cmeldas/ElZa/README.md

# ElZa
Elektronické zapalování

Pokus o elektronické zapalování.
