cmeldas/ElZa/zapojení_minus.png

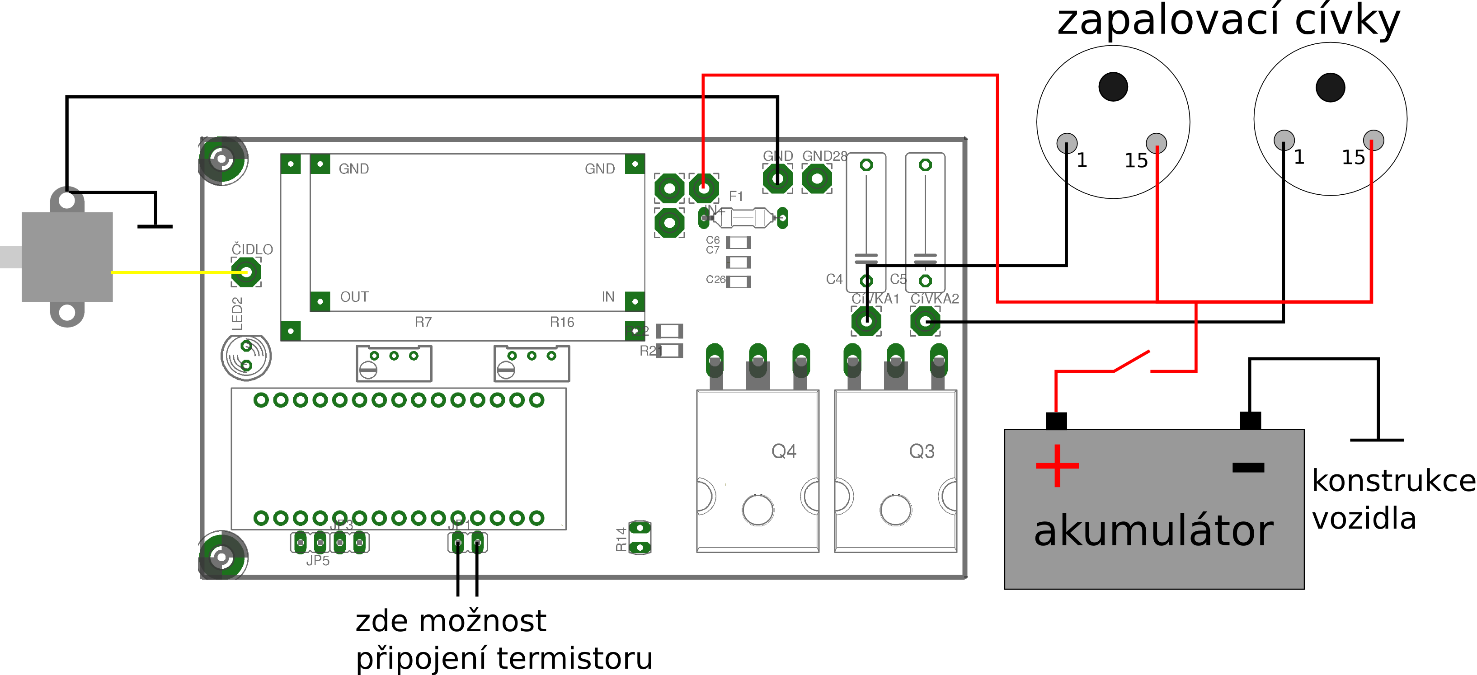
zapojení_minus.png
