cmeldas/ElZa/zapojení_plus.png

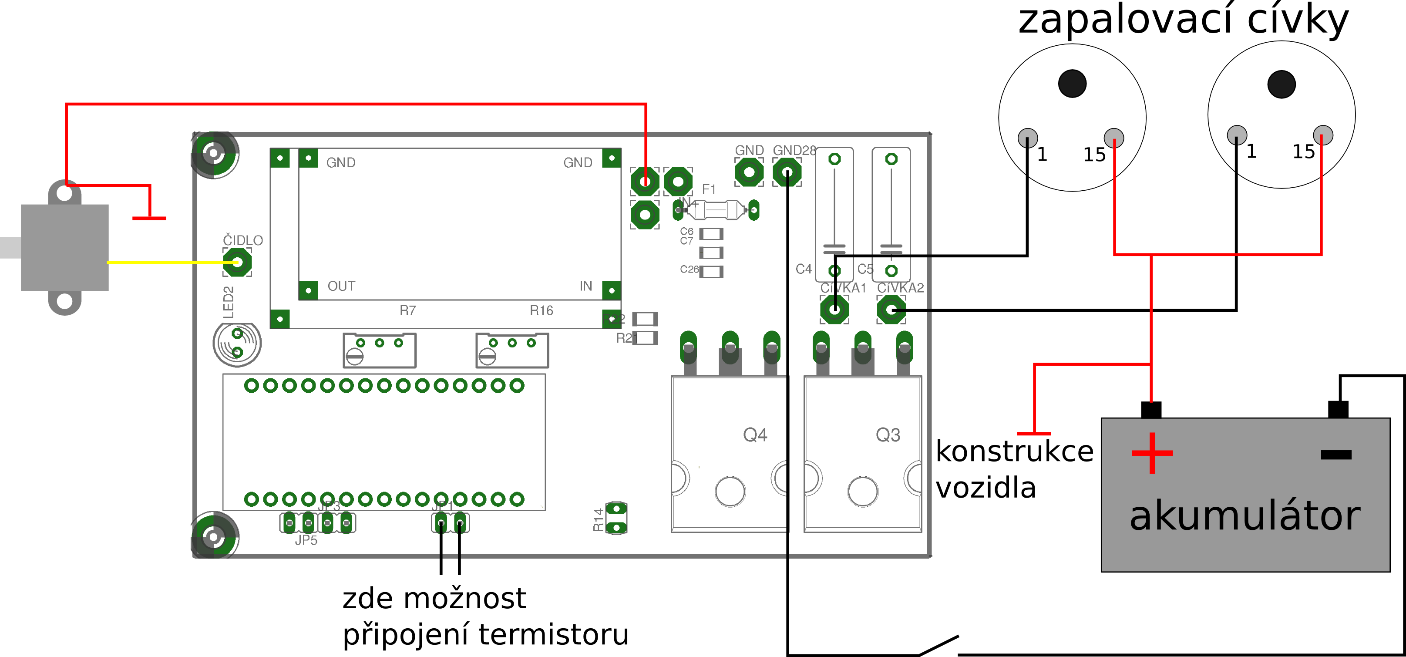
zapojení_plus.png
