cmeldas/ElZa/Eagle/Zapalování_ARDUINO.brd

## EAGLE design Eagle/Zapalování_ARDUINO.brd (2016-06-01)

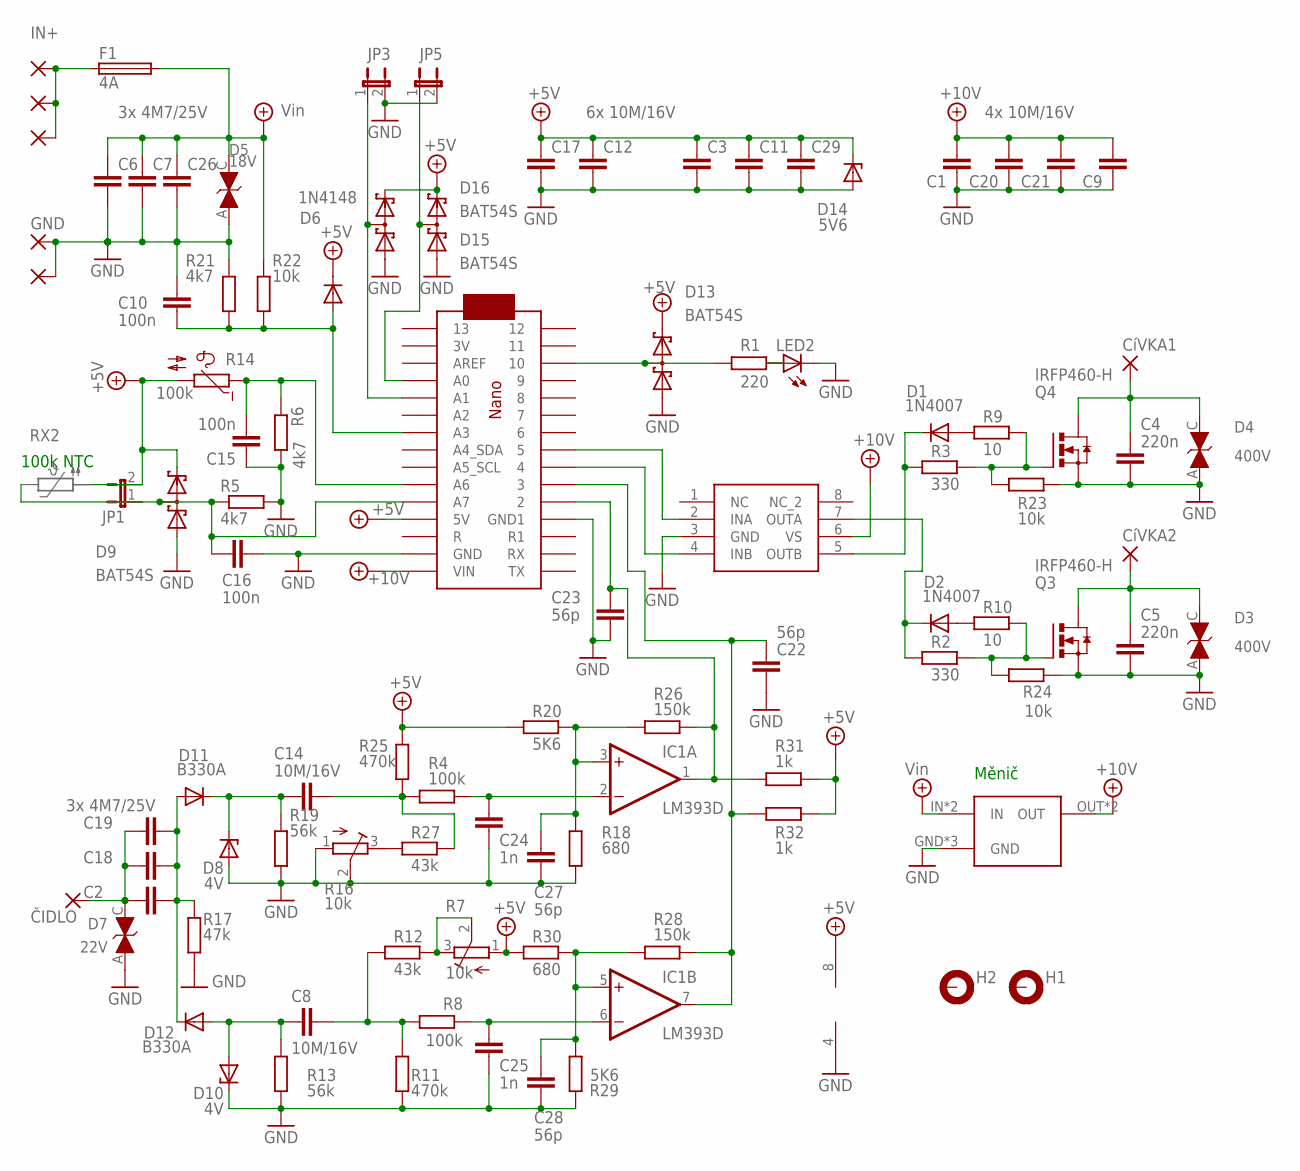
[picture p3: schematic Zapalování_ARDUINO.sch]

Parts:
C1, C8, C9, C11, C12, C14, C17, C20, C29: 10M/16V; C1206K
C2, C26: 3x 4M7/25V; C1206K
C3: 6x 10M/16V; C1206K
C4, C5: 220n; C150-054X183
C6, C7, C18, C19: 4M7/25V; C1206K
C10, C15, C16: 100n; C1206K
C21: 4x 10M/16V; C1206K
C22, C23, C27, C28: 56p; C1206K
C24, C25: 1n; C1206K
CIVKA+: 3,81/1,4
CíVKA1, CíVKA2: 3,81/1,4
CíVKA+: 3,81/1,4
D1, D2: 1N4007; SMA-DO214AC
D3, D4: 400V; SMC
D5: 18V; SMC
D6: 1N4148; SOD80C
D7: 22V; SMC
D8, D10: 4V; SOD80C
D9, D13, D15, D16: BAT54S; SOT23
D11, D12: B330A; DO214BA
D14: 5V6; SOD80C
F1: 4A; PICOFUSE
GND, GND28: 3,81/1,4
H1, H2: MOUNT-PAD-ROUND3.0; 3,0-PAD
IC1: LM393D; SO08
IN+: 3,81/1,4
JP1, JP3, JP5: JP1E; JP1
LED2: LED5MM
Q3, Q4: IRFP460-H; TO247BH
R1: 220; M1206
R2, R3: 330; M1206
R4, R8: 100k; M1206
R5, R6, R21: 4k7; M1206
R7, R16: 10k; RTRIM64W
R9, R10: 10; M1206
R11, R25: 470k; M1206
R12, R27: 43k; M1206
R13, R19: 56k; M1206
R14: 100k; N640
R17: 47k; M1206
R18, R30: 680; M1206
R20, R29: 5K6; M1206
R22, R23, R24: 10k; M1206
R26, R28: 150k; M1206
R31, R32: 1k; M1206
U$1: ARDUINO_NANO
U$2: IR25600/TC4427; SO08
U$3: STEP:DOWN; STEP-BOARD
ČIDLO: 3,81/1,4

Connections:
+5V: C3.1, C11.1, C12.1, C17.1, C29.1, D6.C, D9.2 (C2), D13.2 (C2), D14.C, D15.2 (C2), D16.2 (C2), IC1.8 (V+), JP1.2, R7.1 (A), R14.2, R20.2, R25.2, R30.2, R31.1, R32.1, U$1.P$23 (5V)
+14V: C6.1, C7.1, C26.1, D5.C, F1.2, R22.2, U$3.IN, U$3.P$1 (IN)
+15V: C1.2, C9.1, C20.2, C21.2, U$1.P$20 (VIN), U$2.6 (VS), U$3.OUT, U$3.P$2 (OUT)
CIVKA1: U$1.P$8 (5), U$2.2 (INA)
CIVKA2: U$1.P$9 (4), U$2.4 (INB)
GND: C1.1, C3.2, C4.2, C5.2, C6.2, C7.2, C9.2, C10.1, C11.2, C12.2, C15.1, C16.1, C17.2, C20.1, C21.1, C22.2, C23.2, C24.2, C25.2, C26.2, C27.2, C28.2, C29.2, D3.A, D4.A, D5.A, D7.A, D8.A, D9.1 (A1), D10.C, D13.1 (A1), D14.A, D15.1 (A1), D16.1 (A1), GND.1, GND28.1, IC1.4 (V-), JP3.2, JP5.2, LED2.K (C), Q3.S, Q4.S, R5.2, R6.2, R11.1, R13.1, R16.1 (A), R16.2 (S), R17.1, R18.1, R19.1, R21.2, R23.1, R24.1, R29.2, U$1.P$12 (GND), U$1.P$21 (GND1), U$2.3 (GND), U$3.GND, U$3.GND2 (GND), U$3.P$3 (GND)
INT1: C23.1, IC1.1 (OUT), R26.1, R31.2, U$1.P$11 (2)
INT2: C22.1, IC1.7 (OUT), R28.1, R32.2, U$1.P$10 (3)
unnamed: Q4.G, R3.2, R9.2, R23.2
unnamed: D1.K (C), R3.1, U$2.5 (OUTB)
unnamed: C4.1, CíVKA1.1, D4.C, Q4.D
unnamed: Q3.G, R2.2, R10.2, R24.2
unnamed: D2.K (C), R2.1, U$2.7 (OUTA)
unnamed: D15.3 (C1A2), JP3.1, U$1.P$30 (A1)
unnamed: D16.3 (C1A2), JP5.1, U$1.P$31 (A0)
unnamed: D13.3 (C1A2), R1.2, U$1.P$3 (10)
unnamed: C16.2, D9.3 (C1A2), JP1.1, R5.1, U$1.P$24 (A7)
unnamed: C28.1, IC1.5 (+IN), R28.2, R29.1, R30.1
unnamed: C24.1, IC1.2 (-IN), R4.1
unnamed: LED2.A, R1.1
unnamed: C27.1, IC1.3 (+IN), R18.2, R20.1, R26.2
unnamed: C2.2, C18.2, C19.2, D7.C, ČIDLO.1
unnamed: C14.2, D8.C, D11.C, R19.2
unnamed: C15.2, R6.1, R14.1, U$1.P$25 (A6)
unnamed: C2.1, C18.1, C19.1, D11.A, D12.C, R17.2
unnamed: C25.1, IC1.6 (-IN), R8.1
unnamed: R7.2 (S), R7.3 (E), R12.1
unnamed: C8.1, R8.2, R11.2, R12.2
unnamed: R16.3 (E), R27.2
unnamed: C8.2, D10.A, D12.A, R13.2
unnamed: D2.A, R10.1
unnamed: D1.A, R9.1
unnamed: C5.1, CíVKA2.1, D3.C, Q3.D
unnamed: C14.1, R4.2, R25.1, R27.1
unnamed: C10.2, D6.A, R21.1, R22.1, U$1.P$28 (A3)
VIN: CIVKA+.1, CíVKA+.1, F1.1, IN+.1

Notes on the sheet:
100k NTC
Měnič

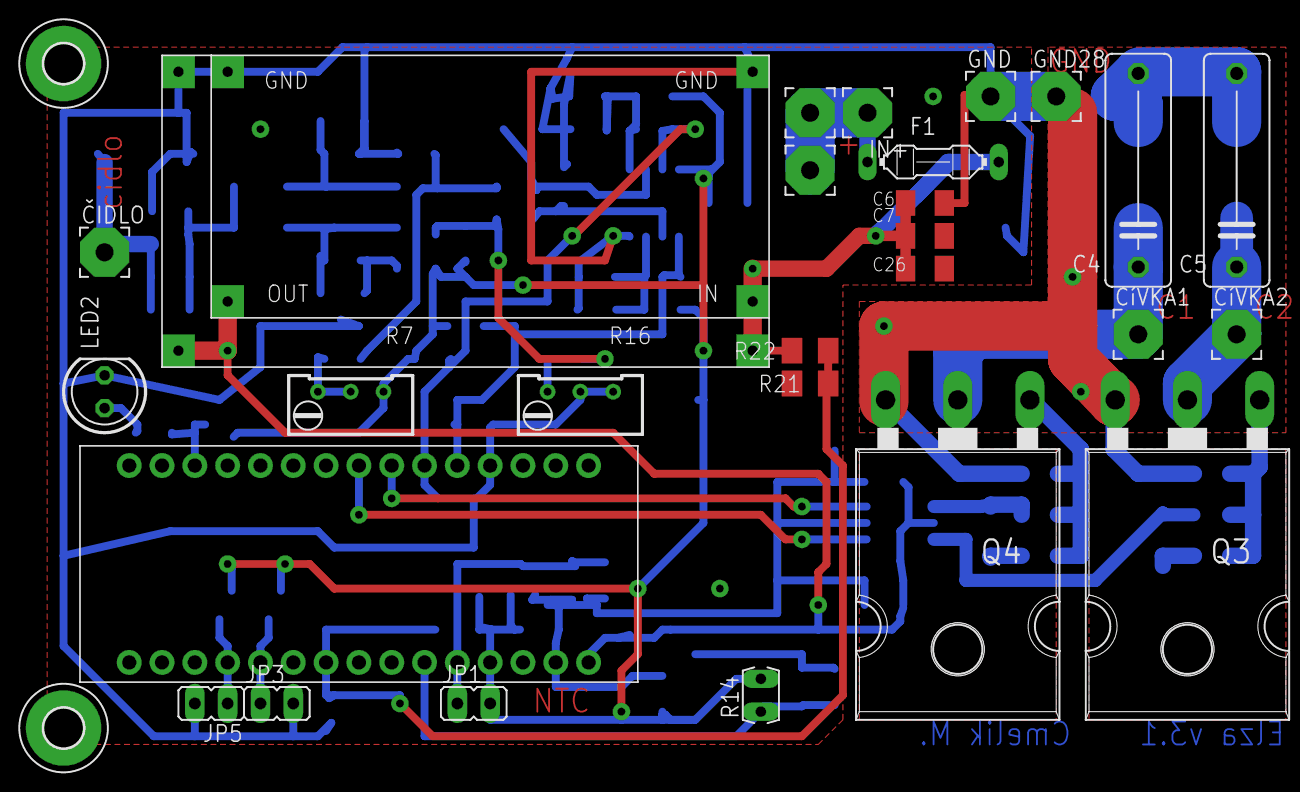
[picture p4: board Zapalování_ARDUINO.brd from above]

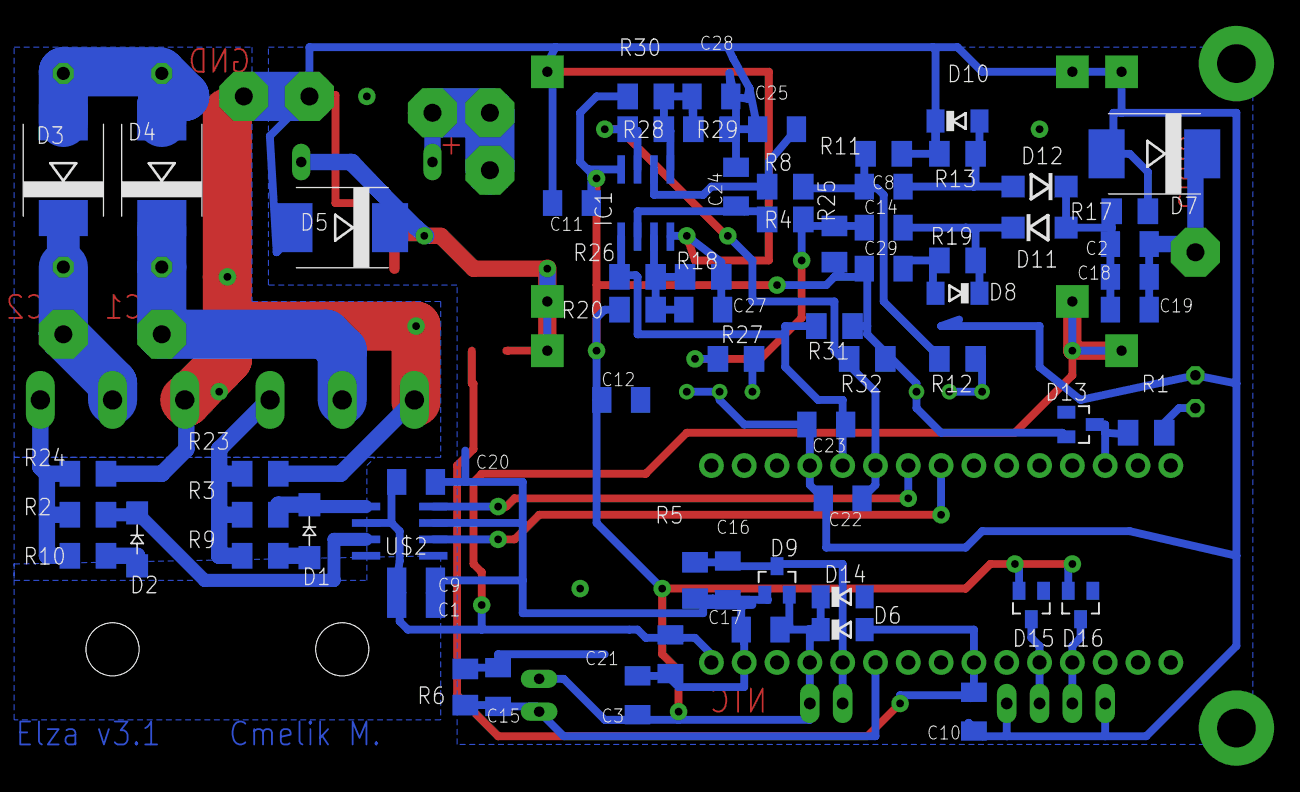
[picture p5: board Zapalování_ARDUINO.brd from below]

Board: 2 copper layers, 96 parts (67 on the bottom side), 36 nets.
