cmeldas/ElZa/Program/src/pins.h

#define INT1_P 3          //rising voltage
#define INT2_P 2          //falling voltage
#define LED_R 13
#define LED_G 10

#define CIVKA1P 4
#define CIVKA2P 5

#define NTC1_P A6
#define NTC2_P A7

#define VOLTAGE_P A3

#define TL1_P A0
#define TL2_P A1

int unussedPin []={6,7,9,8,11,12};
